D0t-Matrix/CPS498-S21-Team04/Schematic/Generic CPS 498 Looper Schematic_schem.pdf

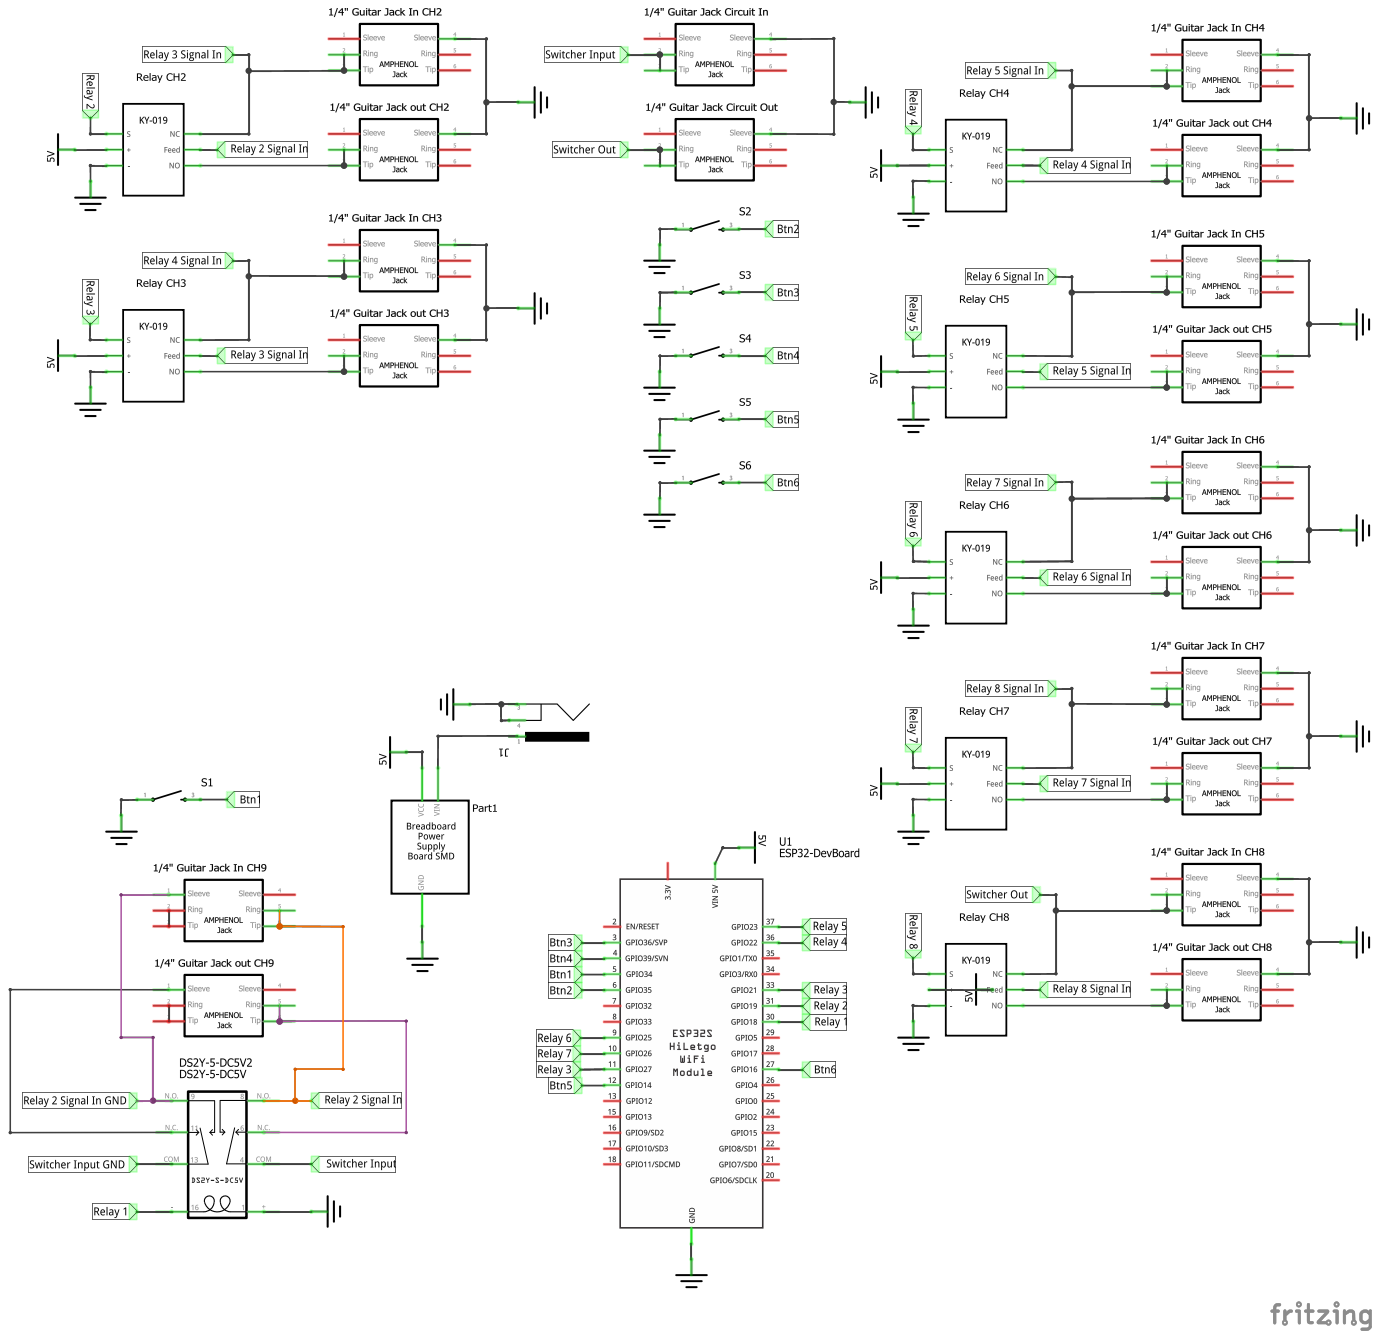
[picture p6: page 1]
