D0t-Matrix/CPS498-S21-Team04/(list of files, drawings)

Other design files:
Schematic/Generic CPS 498 Looper Schematic.fzz
