D0t-Matrix/CPS498-S21-Team04/(commit log)

2021-03-31 Current Application
2021-03-31 Updating README to reflect current goals and instructions
2021-04-20 Adding Schematic used for design
    `.fzz` file is a Fritzeng Schematic project file, containing all network routings should new designs be needed. `.pdf` file is a printout of the schematic for documentation
    [Generic CPS 498 Looper Schematic.fzz]
2021-04-20 Adding images of Switcher
    Images and Videos will be contained within this folder.
2021-04-20 Added Bluetooth/Dashboard button onClick
2021-04-20 Edit Buttons Changing/ToastMessage
2021-04-21 Bluetooth connection through device.
2021-04-27 Updated channel 1 for new design.
    Done for sake of website.
    [Generic CPS 498 Looper Schematic.fzz]
2021-05-01 Updated Schematic and printout to reflect new channel design. Only updated schematic for one channel due to time constraints.
    [Generic CPS 498 Looper Schematic.fzz]
2021-05-01 Adding Schematic Image
2021-05-01 Updated Schematic Image to reflect modification.
2021-05-01 Updated Schematic
    [Generic CPS 498 Looper Schematic.fzz]
2021-05-01 renaming schematic temp
2021-05-01 Updating Schematic to reflect new design
    [Generic CPS 498 Looper Schematic.fzz]
2021-05-01 Pushing correction of Hardware Code
    [Proof_of_Bluetooth_Connectivity.ino, Proof_of_Hardware_Design.ino]
